ARMCoderBR/z80computer-release/kraft80/Captura de tela_2025-10-11_11-37-06.png

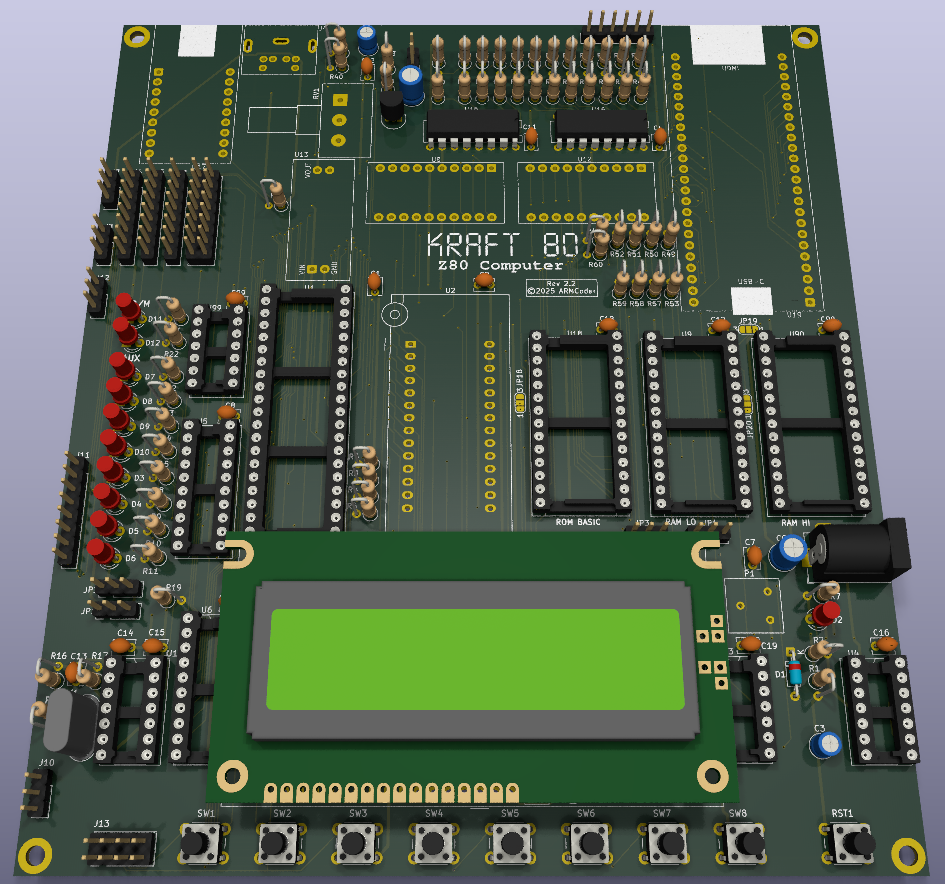
kraft80/Captura de tela_2025-10-11_11-37-06.png
