ARMCoderBR/z80computer-release/kraft80/hardware/buttons.png

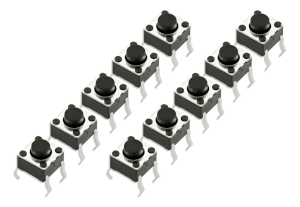
kraft80/hardware/buttons.png
