ARMCoderBR/z80computer-release/kraft80/hardware/dispbaixo.png

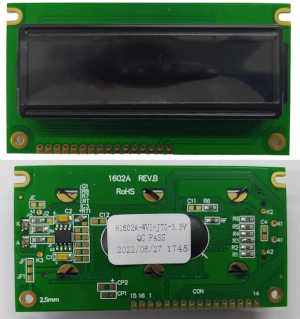
kraft80/hardware/dispbaixo.png
