ARMCoderBR/z80computer-release/kraft80/hardware/jumper3.jpg

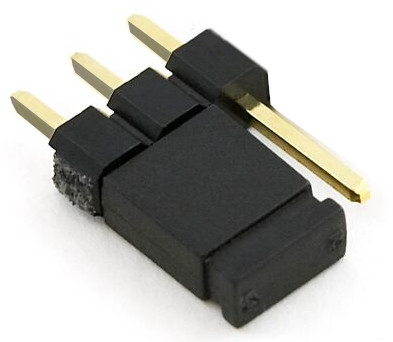
kraft80/hardware/jumper3.jpg
