ARMCoderBR/z80computer-release/kraft80/hardware/jumper_-_2_pin__prt-09044__02.jpg

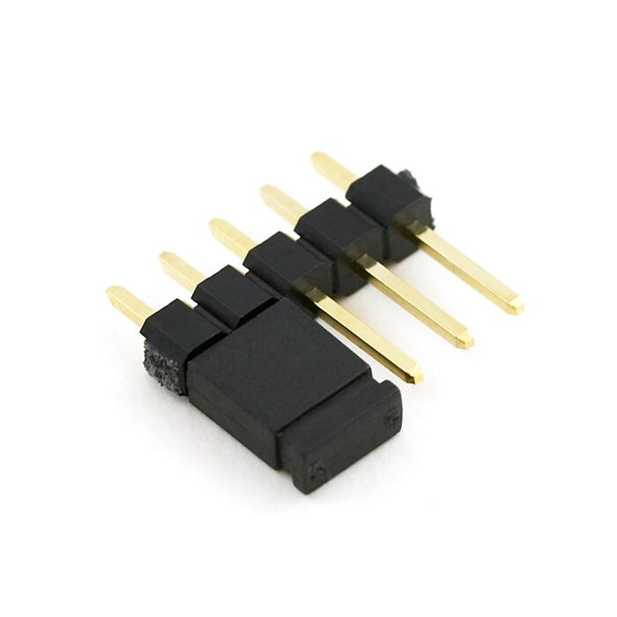
kraft80/hardware/jumper_-_2_pin__prt-09044__02.jpg
