ARMCoderBR/z80computer-release/kraft80/hardware/lvl-shift.png

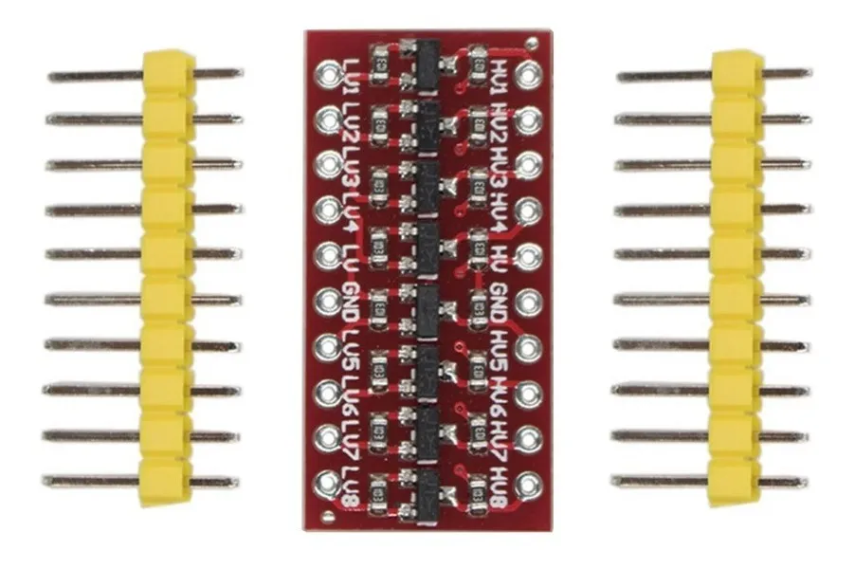
kraft80/hardware/lvl-shift.png
