ARMCoderBR/z80computer-release/kraft80/hardware/minidin.png

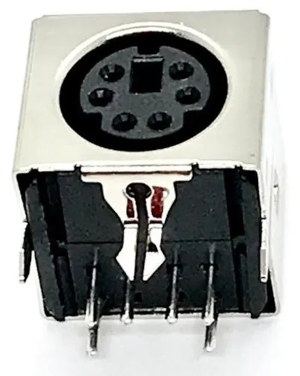
kraft80/hardware/minidin.png
