ARMCoderBR/z80computer-release/kraft80/hardware/USB-SERIAL.png

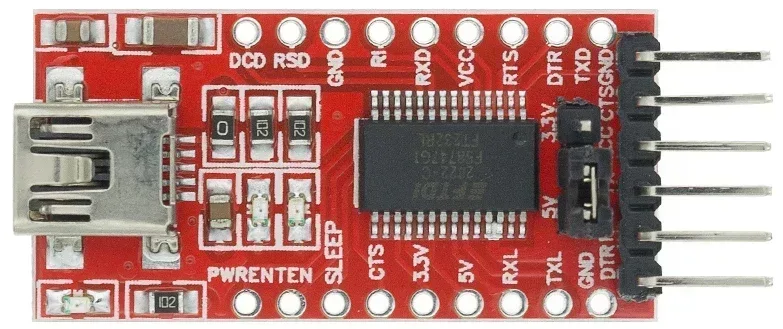
kraft80/hardware/USB-SERIAL.png
