ARMCoderBR/z80computer-release/kraft80/hardware/xtal.png

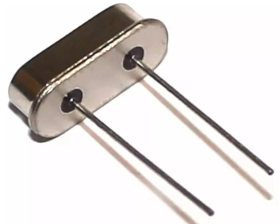
kraft80/hardware/xtal.png
