ARMCoderBR/z80computer-release/kraft80/kraft80-pcb.png

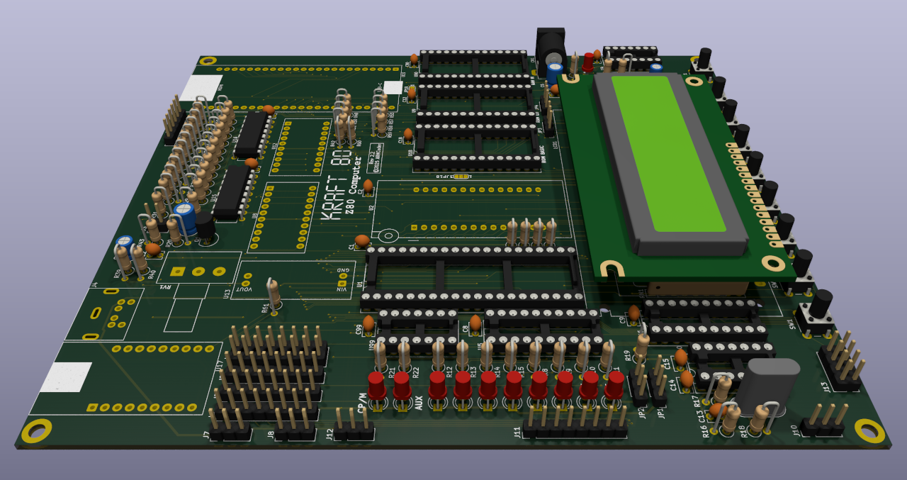
kraft80/kraft80-pcb.png
