ARMCoderBR/z80computer-release/kraft80/hardware/Kraft80V2.pdf

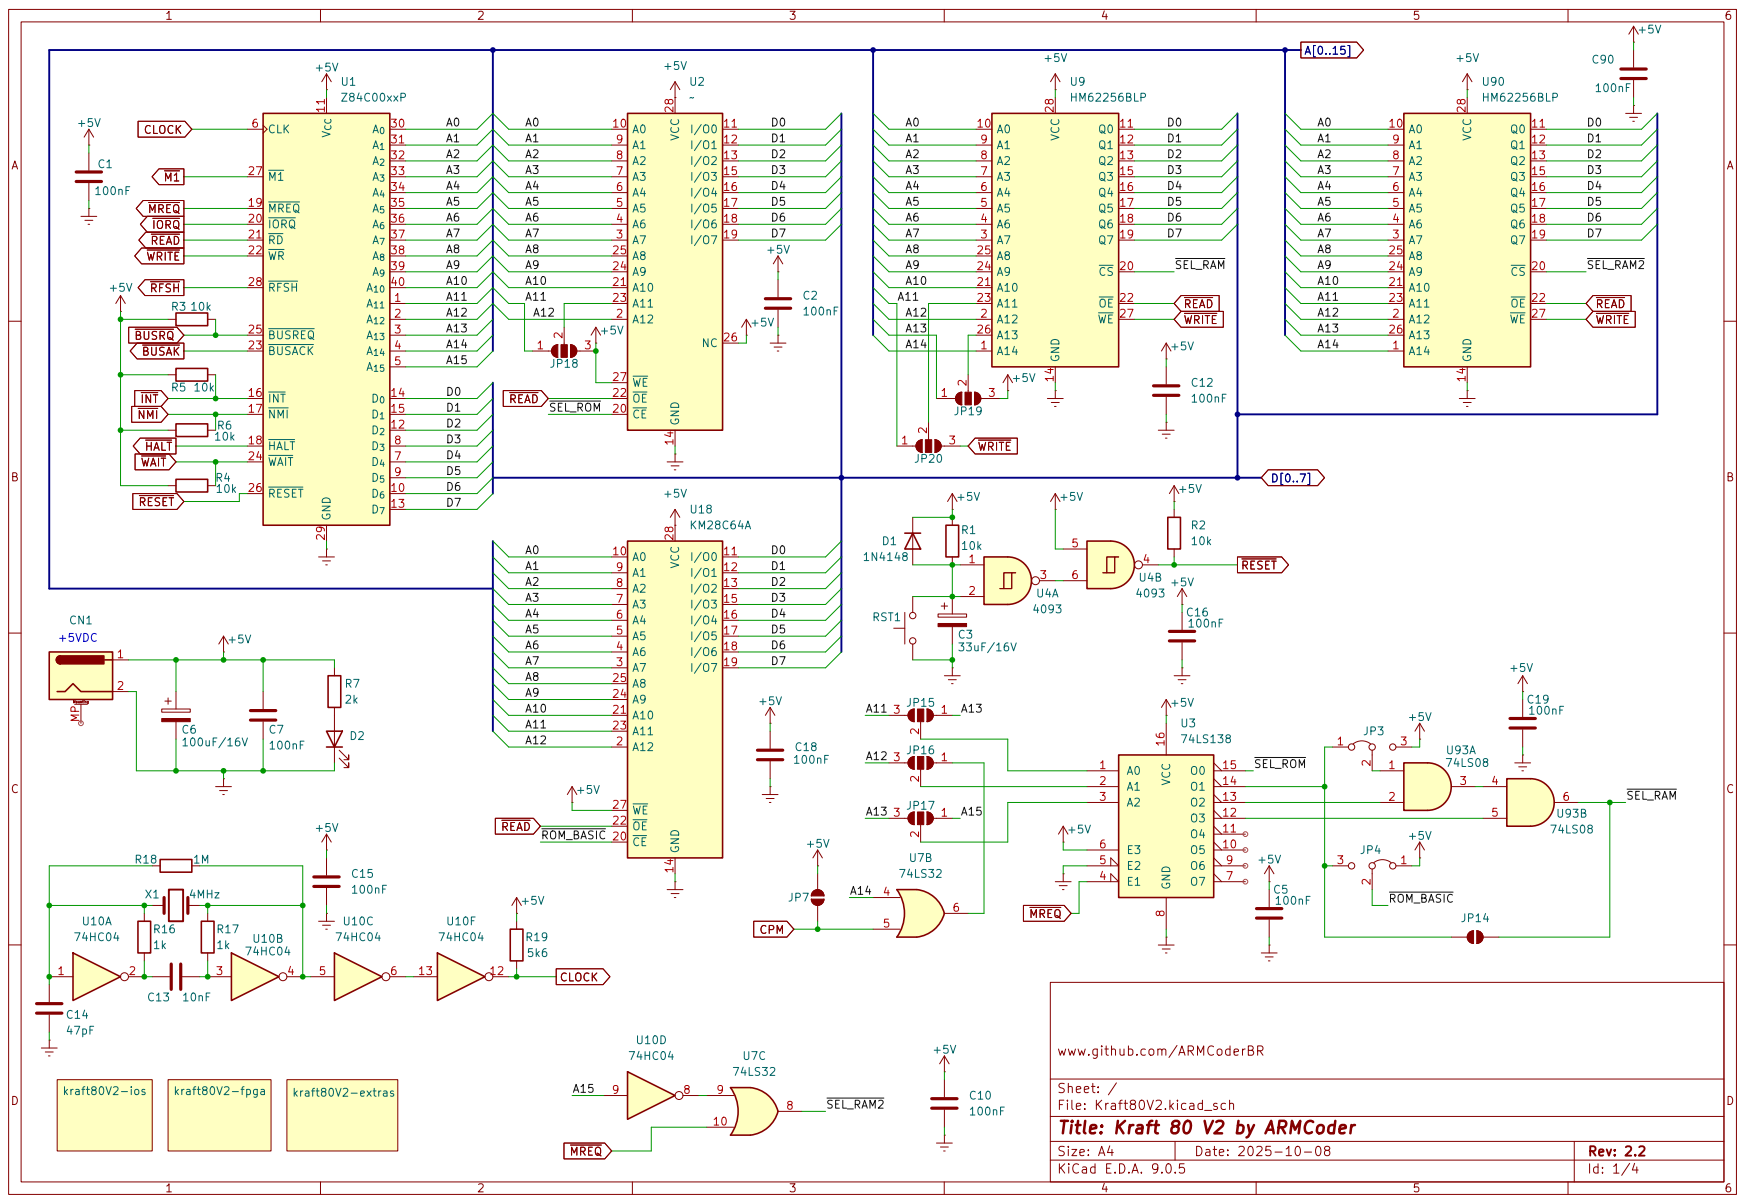
[picture p25: page 1]

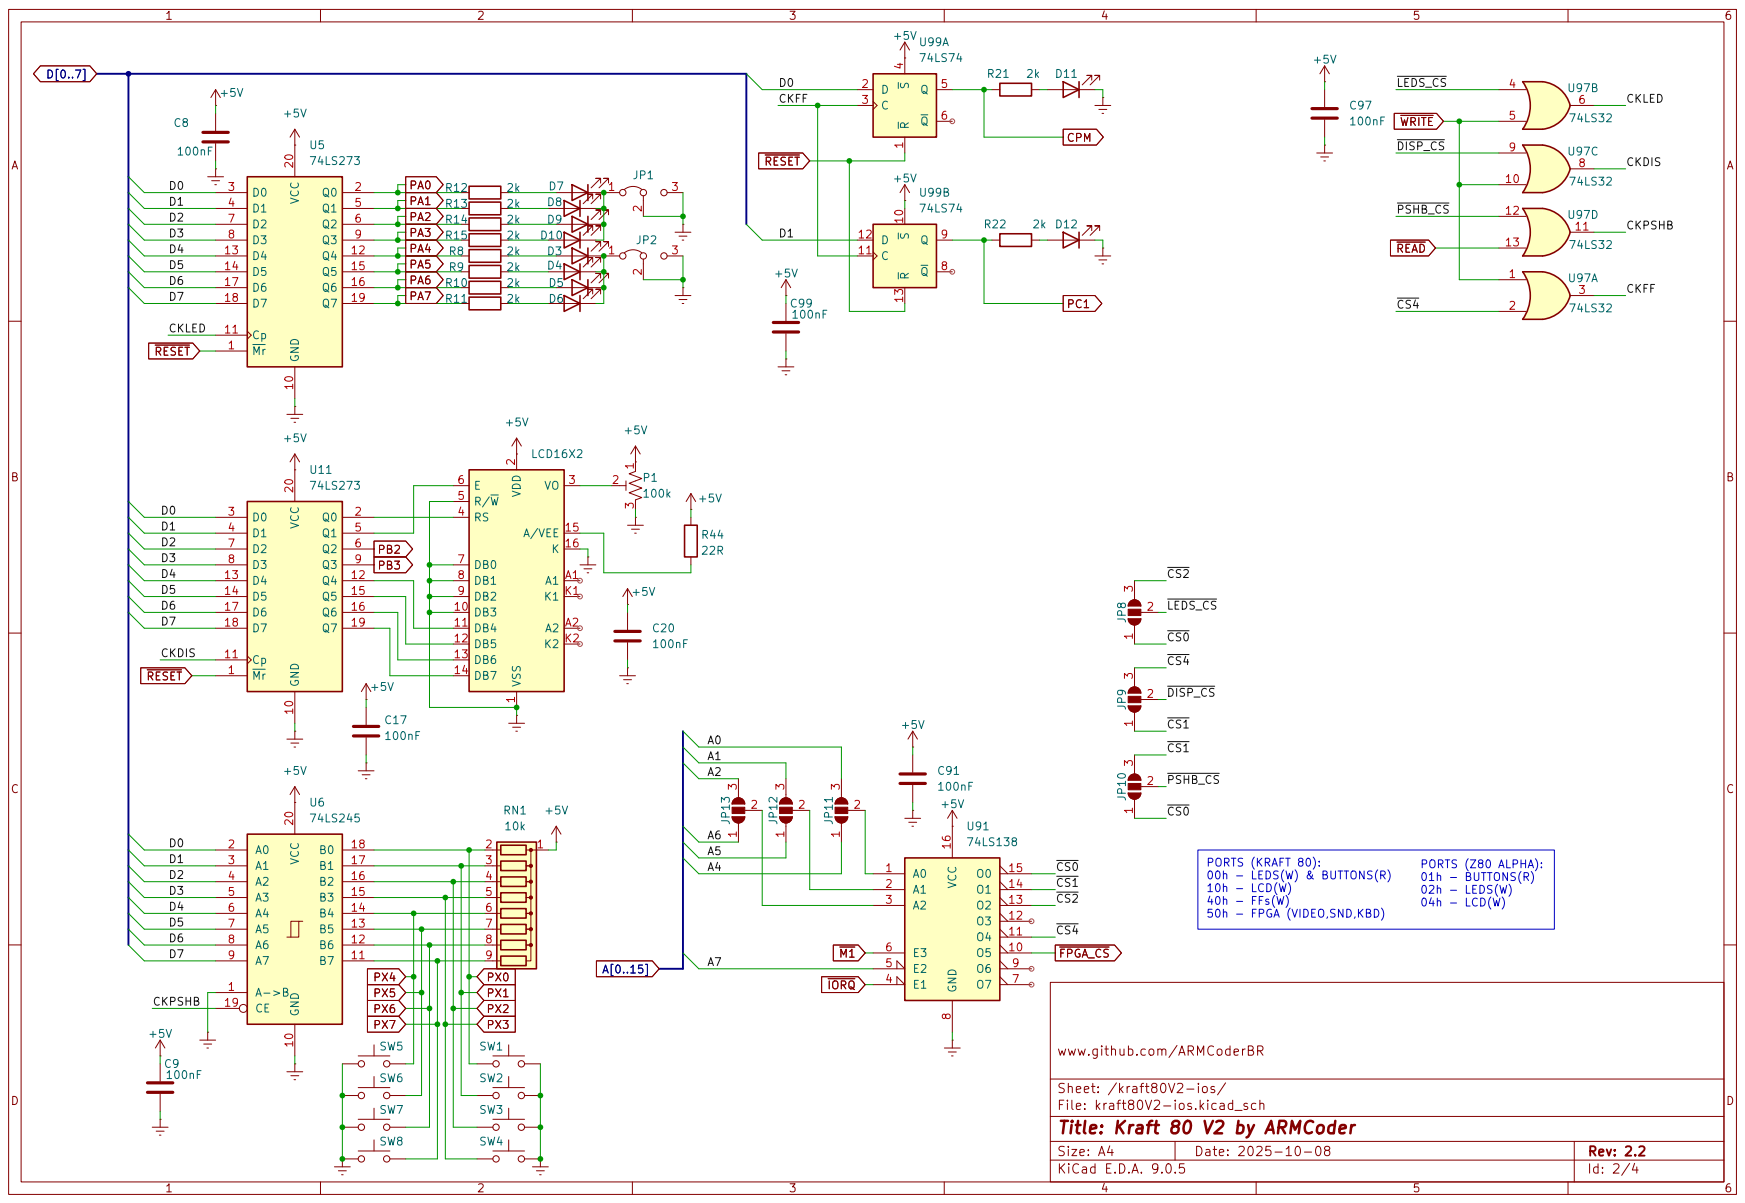
[picture p26: page 2]

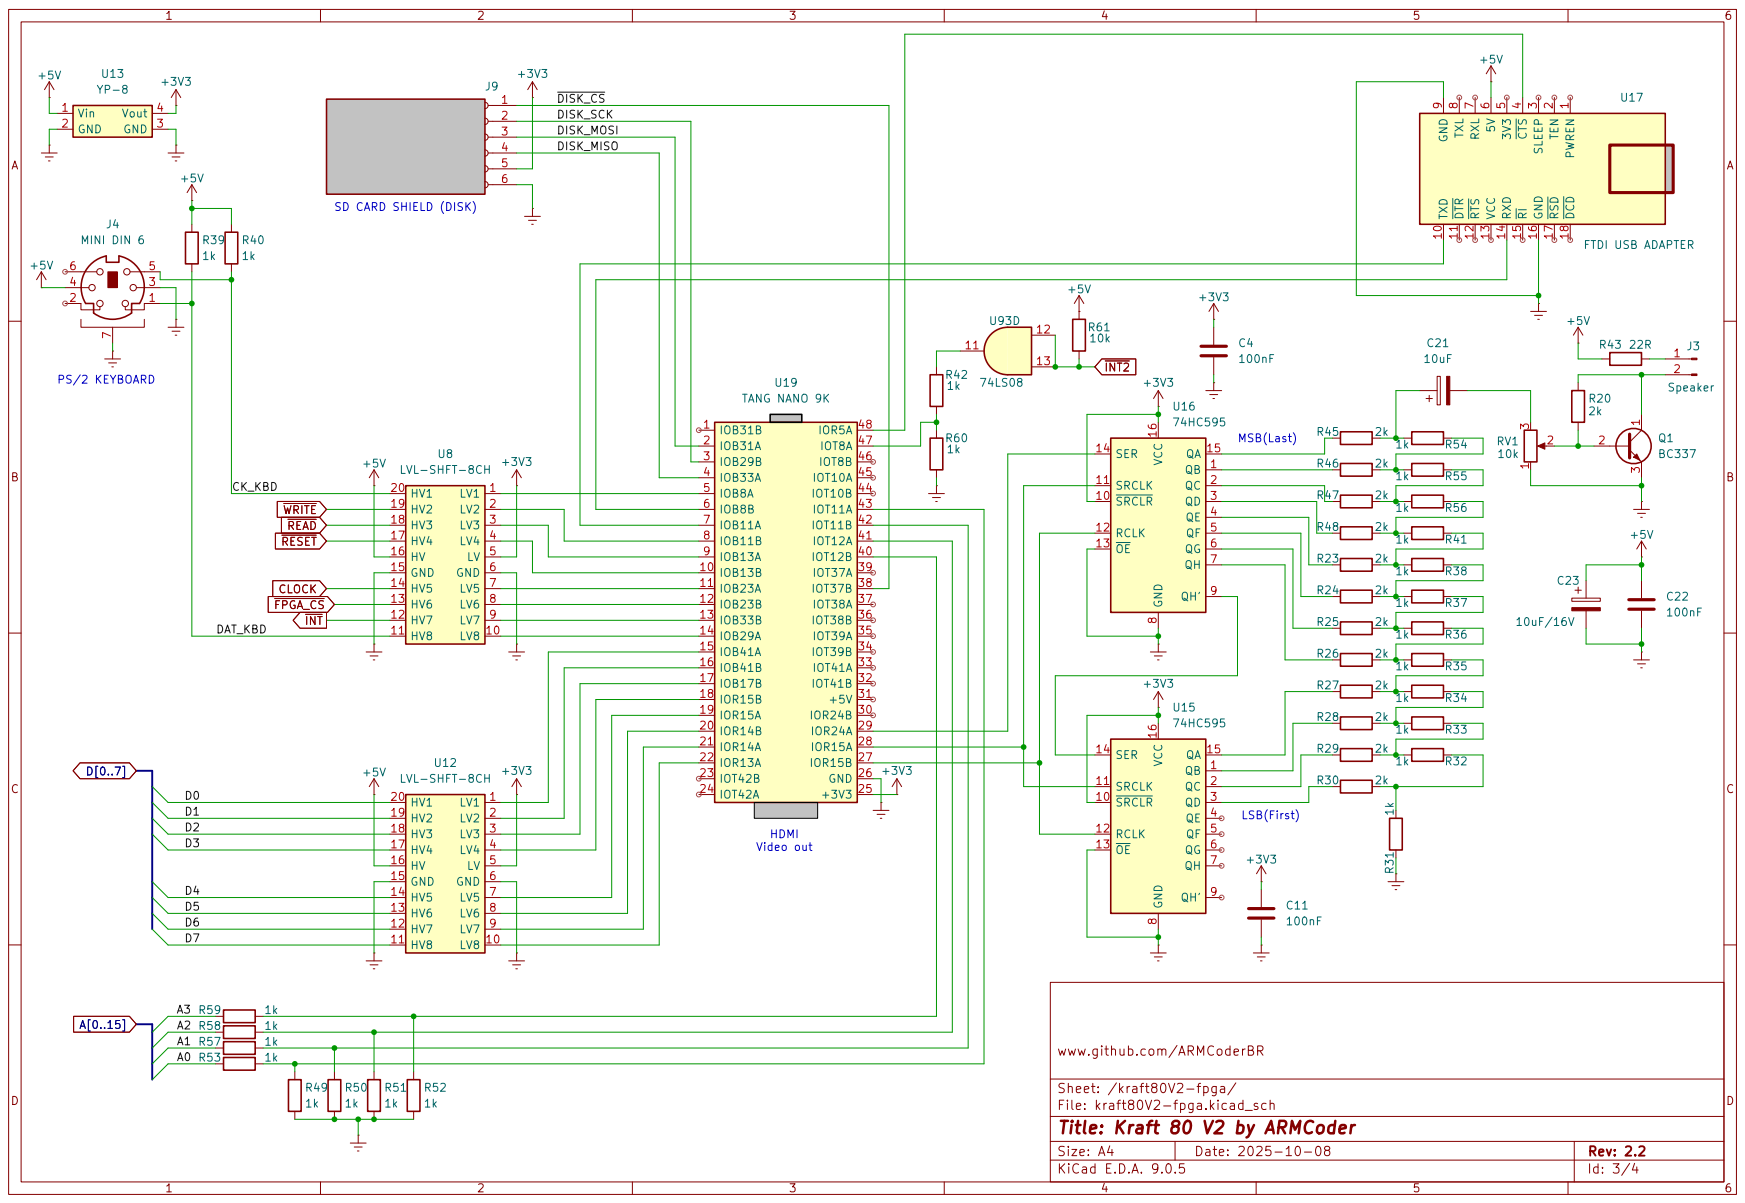
[picture p27: page 3]

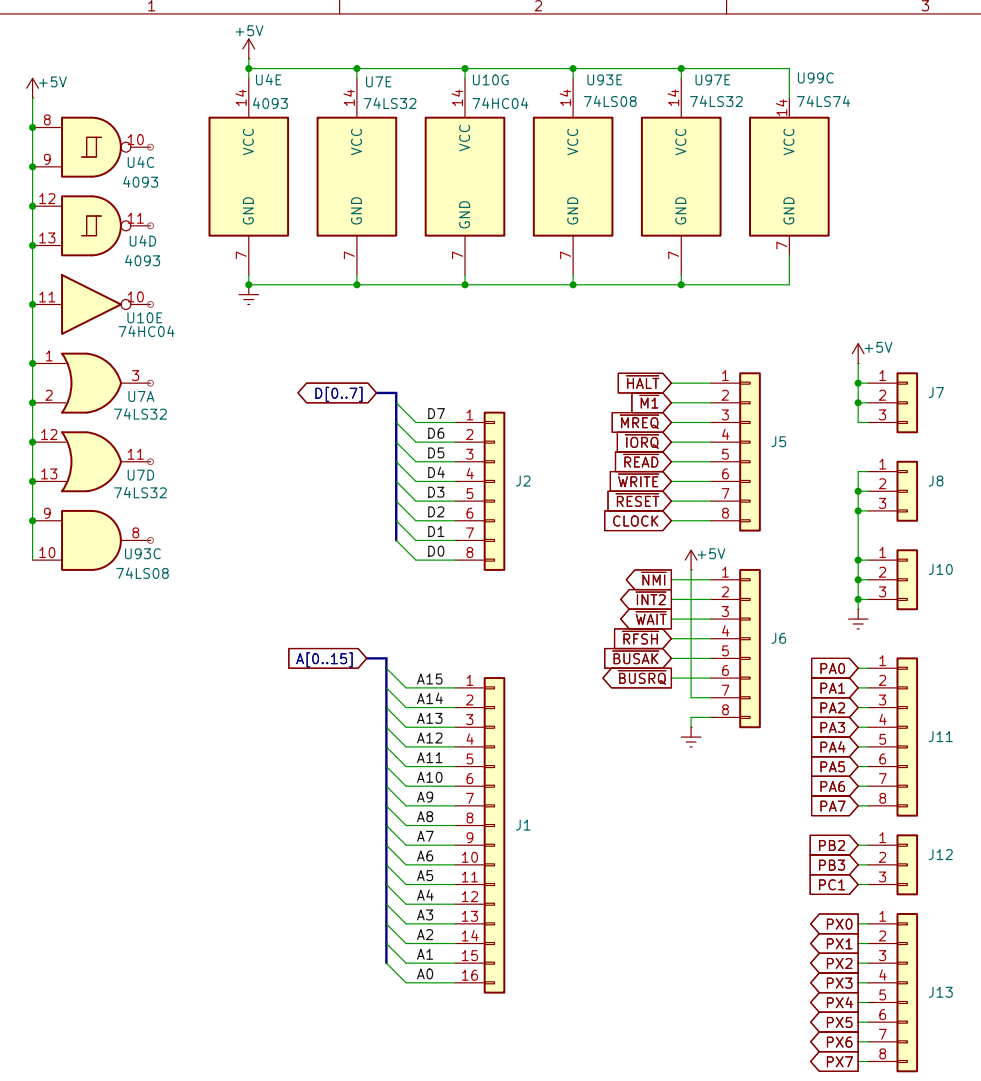
[picture p28: page 4]
