ARMCoderBR/z80computer-release/(commit log)

2025-11-20 Update Kraft80 Hardware Rev 2.2
    [Kraft80V2-B_Cu.gbr, Kraft80V2-B_Mask.gbr, Kraft80V2-B_Paste.gbr, Kraft80V2-B_Silkscreen.gbr, Kraft80V2-Edge_Cuts.gbr, Kraft80V2-F_Cu.gbr, Kraft80V2-F_Mask.gbr, Kraft80V2-F_Paste.gbr]
2026-04-15 Support for CH376 Flash Drive Controller
    [device.cfg]
